SNR-Tech-Bytes/3D-Printer-Companion-Board/README.md

# 3D-Printer-Companion-Board
3D Printer Companion Board for voltage regulation and enclosure interface
For more information watch this video: https://youtu.be/JjFgt_RT7m0
