SNR-Tech-Bytes/3D-Printer-Companion-Board/Companion board enclosure top.stl

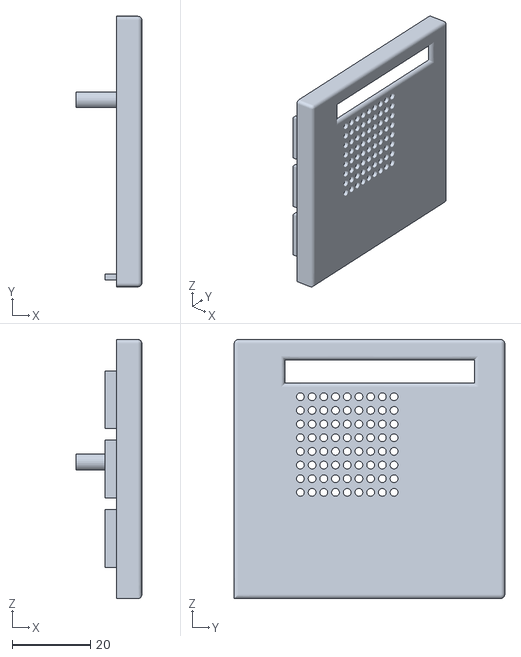
[picture p1: CAD file, 2021-02-24]
Companion board enclosure top.stl
16.8 x 69.3 x 66.4
