SNR-Tech-Bytes/3D-Printer-Companion-Board/Companion board enclosure bottom.stl

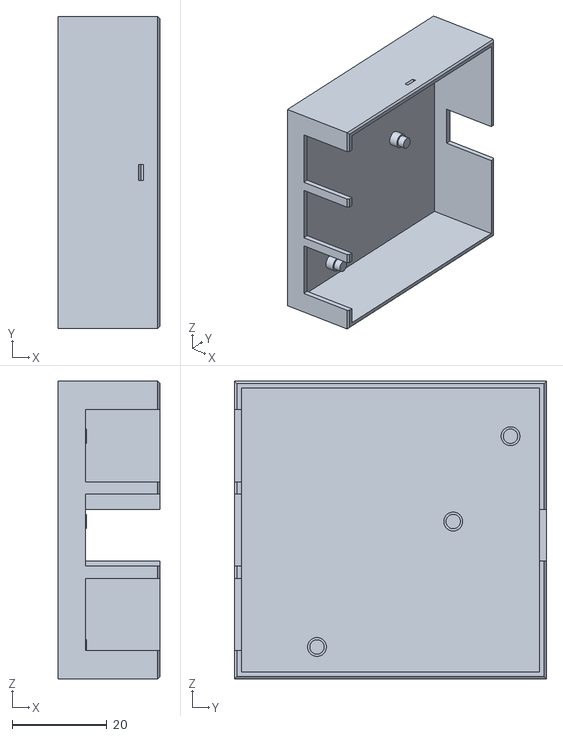
[picture p2: CAD file, 2021-02-24]
Companion board enclosure bottom.stl
21.5 x 65.8 x 62.9
