SNR-Tech-Bytes/3D-Printer-Companion-Board/3d_printer_neo_fan_control 2.brd

## EAGLE design 3d_printer_neo_fan_control 2.brd (2021-02-24)

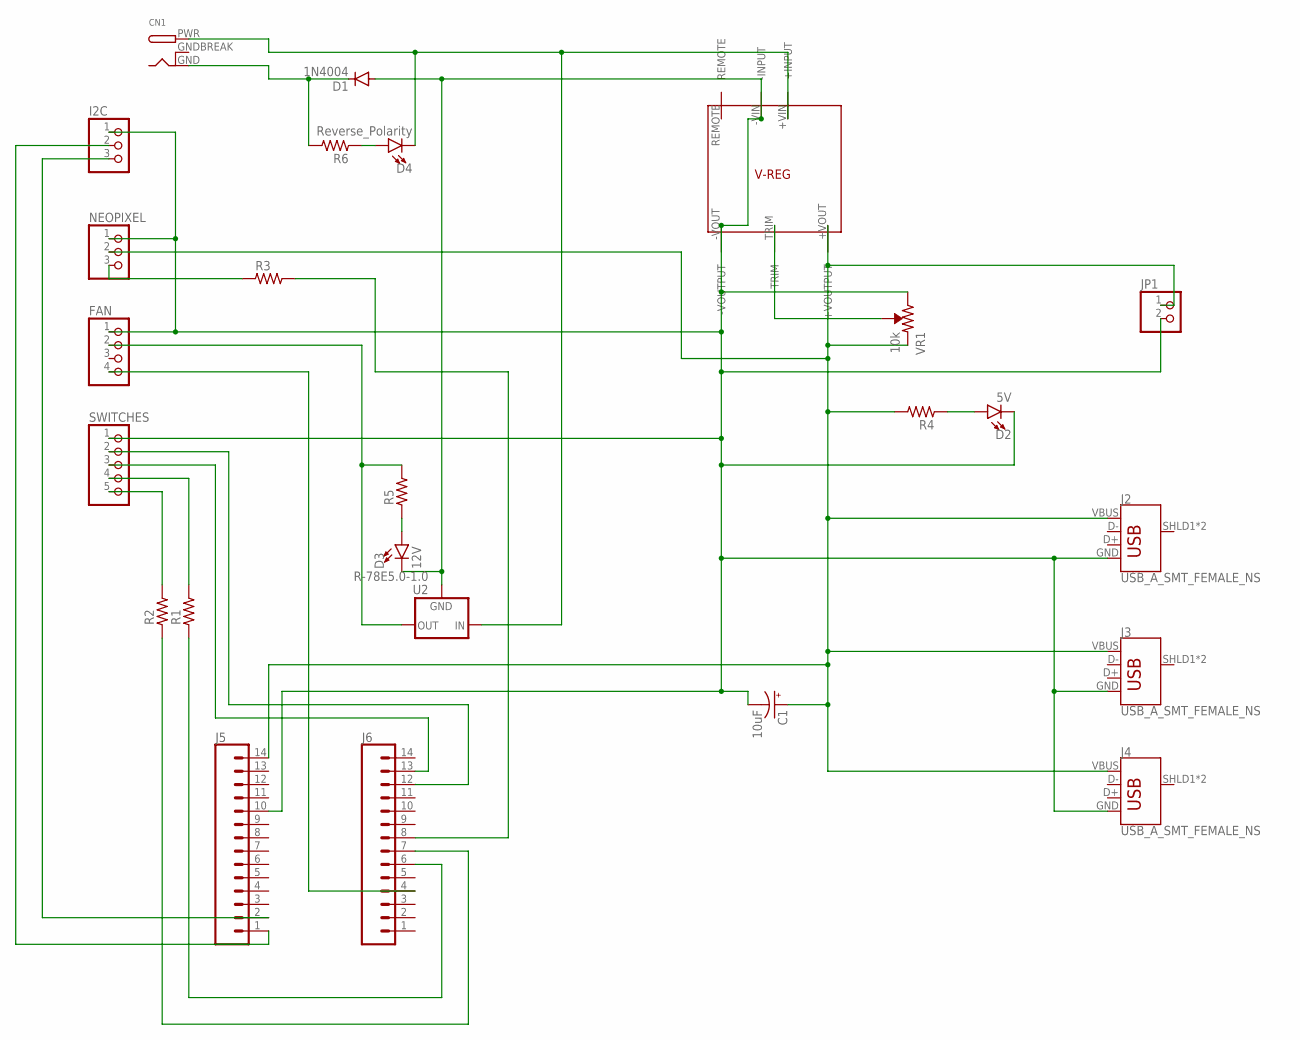
[picture p3: schematic 3d_printer_neo_fan_control 2.sch]

Parts:
C1: 10uF; CPOL-RADIAL-2.5MM-5MM-KIT
CN1: DCBARRELPTH; DCJACK_2MM_PTH
D1: 1N4004; DO41-10
D2: 5V; LED-1206
D3: 12V; LED-1206
D4: Reverse_Polarity; LED-1206
FAN: PINHD-1X4; 1X04
I2C: PINHD-1X3; 1X03
J2, J3, J4: USB_A_SMT_FEMALE_NS; USB-A-S-NOSILK-FEMALE
J5, J6: CONN_14; 1X14
JP1: PINHD-1X2; 1X02
NEOPIXEL: PINHD-1X3; 1X03
R1, R2, R3, R4, R5, R6: RC-MASTER-SMD_R_1206MP; RC-MASTER-SMD_R1206MP
SWITCHES: PINHD-1X5; 1X05
U2: R-78E5.0-1.0; DC-DC_CONVERTER_78XX
U$1: CINCON-EC4SBW
VR1: 10k; TRIMPOT-SMD-TC33X

Connections:
5V: C1.1 (+), J2.VBUS, J3.VBUS, J4.VBUS, J5.14, JP1.1, NEOPIXEL.2, R4.2, U$1.+VOUT (+VOUTPUT), VR1.3 (CCW)
5V_GND: C1.2 (-), D1.A, D2.C, D3.C, FAN.1, I2C.1, J2.GND, J3.GND, J4.GND, J5.10, JP1.2, NEOPIXEL.1, SWITCHES.1, U2.GND, U$1.-VIN (-INPUT), U$1.-VOUT (-VOUTPUT), VR1.1 (CW)
12V: FAN.2, R5.2, U2.VOUT (OUT)
DIODE: CN1.GND, D1.C, R6.2
GNDBREAK: CN1.GNDBREAK
unnamed: D3.A, R5.1
unnamed: D4.A, R6.1
unnamed: U$1.TRIM, VR1.2 (WIPER)
unnamed: D2.A, R4.1
unnamed: R2.2, SWITCHES.5
unnamed: FAN.4, J6.4
unnamed: R1.2, SWITCHES.4
unnamed: J6.6, R1.1
unnamed: J6.7, R2.1
unnamed: NEOPIXEL.3, R3.1
unnamed: J6.13, SWITCHES.3
unnamed: J6.12, SWITCHES.2
unnamed: J6.8, R3.2
unnamed: I2C.2, J5.1
unnamed: I2C.3, J5.2
VIN: CN1.PWR, D4.C, U2.VIN (IN), U$1.+VIN (+INPUT)

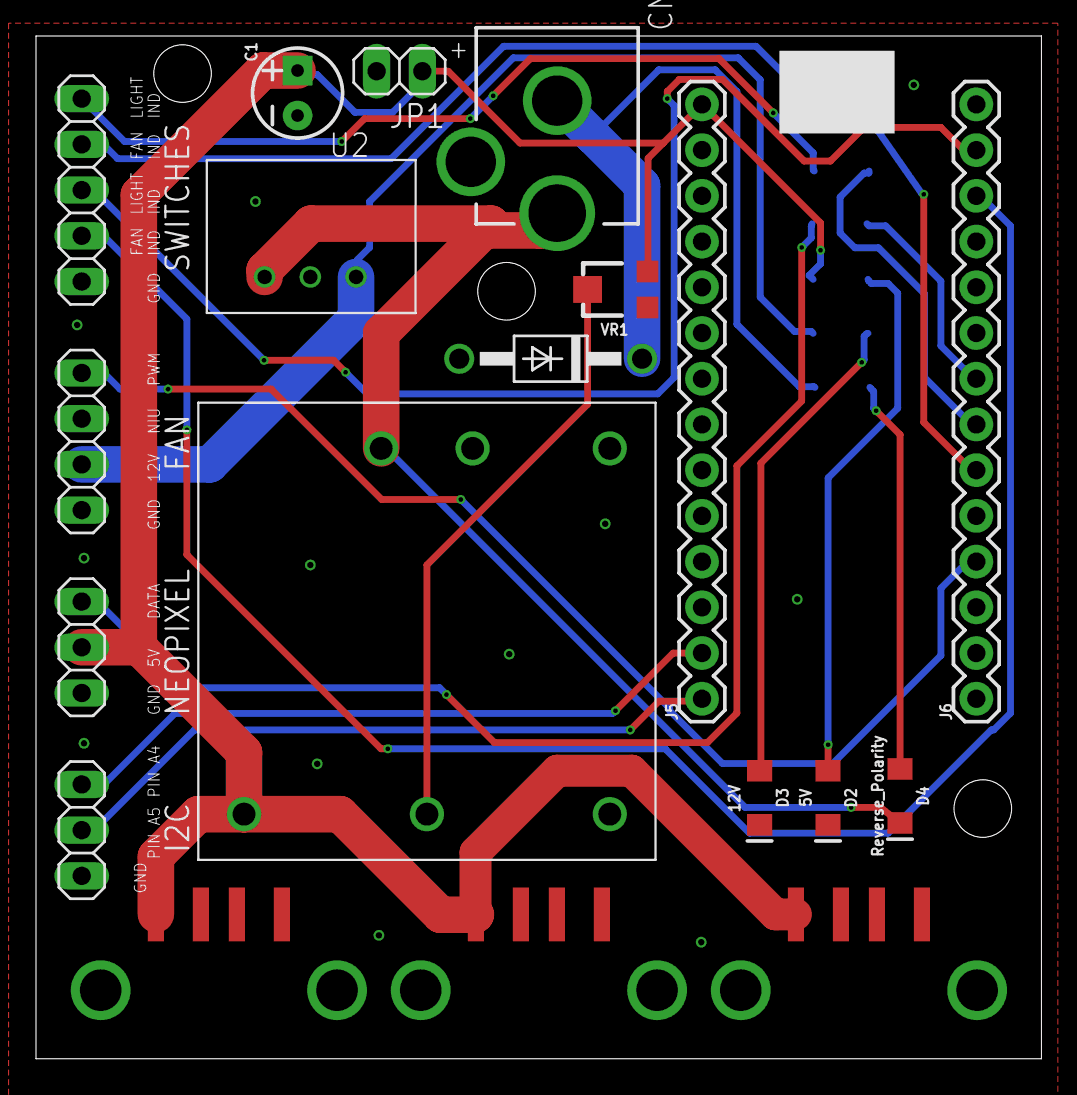
[picture p4: board 3d_printer_neo_fan_control 2.brd from above]

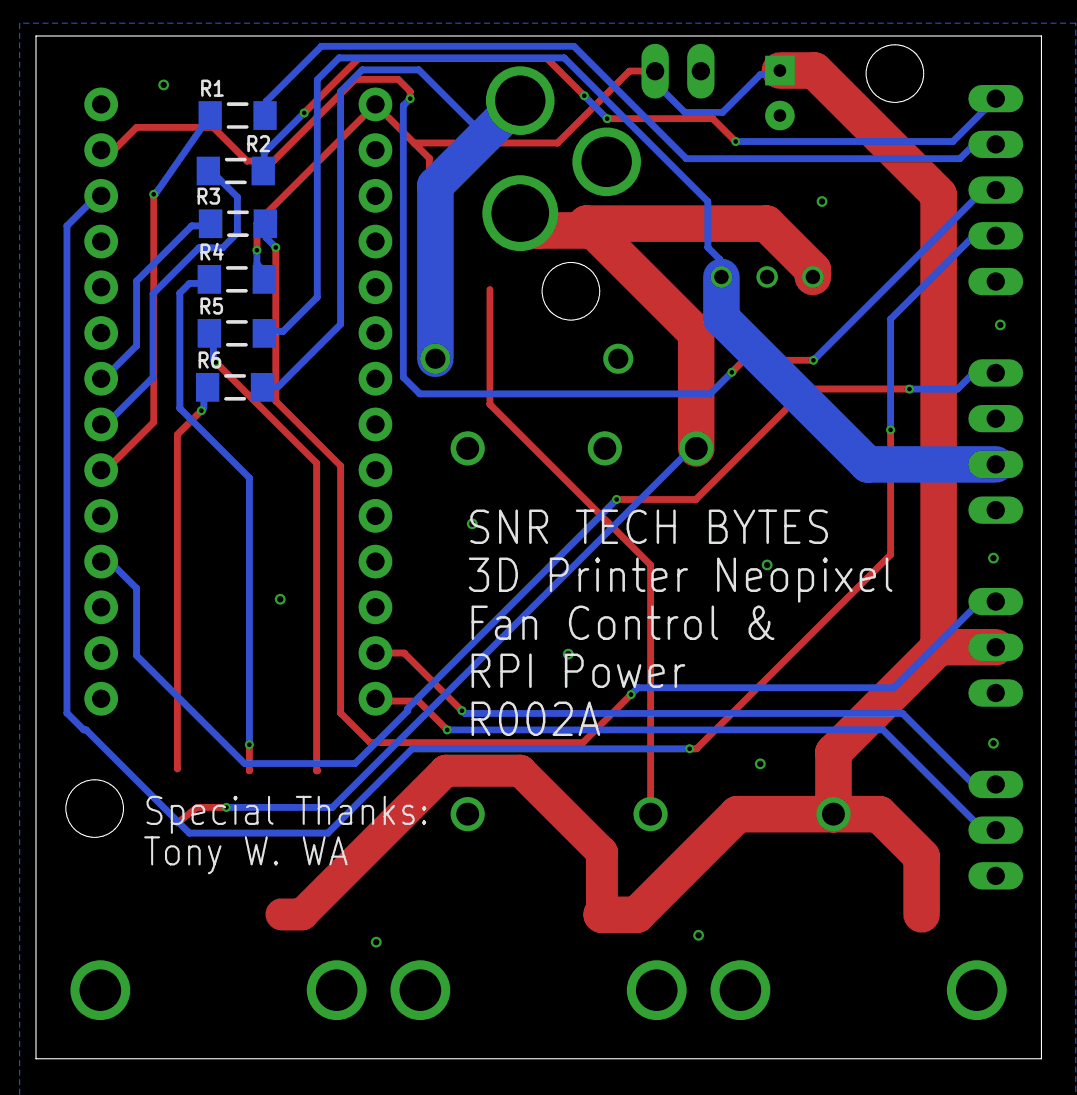
[picture p5: board 3d_printer_neo_fan_control 2.brd from below]

Board: 2 copper layers, 55.9 x 56.8 mm, 25 parts (6 on the bottom side), 20 nets.
