SNR-Tech-Bytes/3D-Printer-Companion-Board/(commit log)

2021-02-24 eagle brd and sch files added
    [3d_printer_neo_fan_control 2.brd, 3d_printer_neo_fan_control 2.sch]
2021-02-24 Added BOM and board component map
    [Bill of Materials.csv, board component values.csv]
2021-02-24 Added enclosure STL's and Arduino code
    [Companion board enclosure bottom.stl, Companion board enclosure top.stl]
2021-02-24 Replaced BRD and SCH with updated files
    [3d_printer_neo_fan_control 2.brd, 3d_printer_neo_fan_control 2.sch]
